Katerrrina-g/Project_SAPR/reports/bom.csv

Refs | Value | Footprint | Qty | DNP | Manufacturer_Part_Number
 | 4,7мк | SAPR:C_0201_0603Metric |  |  | GRM188Z71C475KE21D
 | 47000 | SAPR:C_0201_0603Metric |  |  | GCJ188R71E473KA01D
 | 68000 | SAPR:C_0201_0603Metric |  |  | GRM188R71H683KA93D
 | 1мк | SAPR:C_0201_0603Metric |  |  | GRM033R60J105MEA2D
 | 10мк | SAPR:C_0402_1005Metric |  |  | CC0402MRX5R6BB106
 | 22мк | SAPR:C_0402_1005Metric |  |  | GRM155R60J226ME11D
 | 1мк | SAPR:C_0201_0603Metric |  |  | GRM033R60J105MEA2D
 | 10мк | SAPR:C_0402_1005Metric |  |  | CC0402MRX5R6BB106
 | 1мк | SAPR:C_0201_0603Metric |  |  | GRM033R60J105MEA2D
 | 4,7мк | SAPR:C_0201_0603Metric |  |  | GRM188Z71C475KE21D
 | 0,01мк | SAPR:C_0201_0603Metric |  |  | GRM033R71E103KE14D
 | 10мк | SAPR:R_0402_1005Metric |  |  | CC0402MRX5R6BB106
 | 0,01мк | SAPR:C_0201_0603Metric |  |  | GRM033R71E103KE14D
 | 0,1мк | SAPR:C_0201_0603Metric |  |  | GRM033Z71C104KE14D
 | 0,1мк | SAPR:C_0201_0603Metric |  |  | GRM033Z71C104KE14D
 | 10мк | SAPR:C_1210_3225Metric |  |  | GRM32ER71H106KA12L
 | 10мк | SAPR:C_1210_3225Metric |  |  | GRM32ER71H106KA12L
 | 2,2мк | SAPR:C_0201_0603Metric |  |  | GRM188R71A225KE15D
 | 2,2мк | SAPR:C_0201_0603Metric |  |  | GRM188R71A225KE15D
 | 4,7мк | SAPR:C_0201_0603Metric |  |  | GRM188Z71C475KE21D
 | 10мк | SAPR:C_0402_1005Metric |  |  | CC0402MRX5R6BB106
 | 10мк | SAPR:C_1206_3216Metric |  |  | GRM31CR61H106KA12L
 | 10мк | SAPR:C_1206_3216Metric |  |  | GRM31CR61H106KA12L
 | 1000 | SAPR:C_0402_1005Metric |  |  | GCM155R71H102KA37J
 | 1000 | SAPR:C_0402_1005Metric |  |  | GCM155R71H102KA37J
 | 10мк | SAPR:C_0402_1005Metric |  |  | CC0402MRX5R6BB106
 | 10мк | SAPR:C_0402_1005Metric |  |  | CC0402MRX5R6BB106
 | 0,1мк | SAPR:C_0201_0603Metric |  |  | GRM033Z71C104KE14D
 | 6,8 | SAPR:C_0402_1005Metric |  |  | CC0402CRNPO9BN6R8
 | 33 | SAPR:C_0402_1005Metric |  |  | GRM1555C1H330J
 | 10мк | SAPR:C_1206_3216Metric |  |  | GRM31CR61H106KA12L
 | 10мк | SAPR:C_1206_3216Metric |  |  | GRM31CR61H106KA12L
 | 10мк | SAPR:C_0805_2012Metric |  |  | GRM21BR60J106K
 | 10мк | SAPR:C_0402_1005Metric |  |  | CC0402MRX5R6BB106
 | MDS01L-N | SAPR:MDS01L-N |  |  | MDS01L-05N
 | ISOUSB211 | SAPR:SSOP-28-ISOUSB211 |  |  | ISOUSB211DPR
 | ADP5071AREZ | SAPR:TSSOP-20_4.4x6.5mm_P0.65mm |  |  | ADP5071AREZ
 | LM3671MF-ADJ | SAPR:SOT-23-5 |  |  | LM3671MF-ADJ
 | ADP2301AUJZ-R7 | SAPR:TSOT-23-6
 | TPS7A4901DGNR | SAPR:MSOP-8-1EP_3x3mm_P0.65mm_EP1.95x2.15mm |  |  | TPS7A4901DGNR
 | TPS7A3001DGNR | SAPR:MSOP-8-1EP_3x3mm_P0.65mm_EP1.95x2.15mm |  |  | TPS7A3001DGNR
 | 47мкГн | SAPR:L_TDK_NLV32_3.2x2.5mm |  |  | NLCV32T-470K-EF
 | 6,8мк | SAPR:L_0201_0603Metric |  |  | MLF1608E6R8KTD25
 | 15мк | SAPR:L_0201_0603Metric |  |  | MLF1608C150KTA00
 | 2,2мк | SAPR:L_0201_0603Metric |  |  | ILSB0603ER2R2K
 | 6,8мк | SAPR:L_0201_0603Metric |  |  | MLF1608E6R8KTD25
 | 5,1 | SAPR:R_0402_1005Metric |  |  | RC0402FR-075R1L
 | 12к | SAPR:R_0402_1005Metric |  |  | RC0402FR-0712KL
 | 15к | SAPR:R_0402_1005Metric |  |  | RC0402FR-0715RL
 | 1Г | SAPR:R_1206_3216Metric |  |  | CRHV1206AF1G00FKET
 | 0 | SAPR:R_0201_0603Metric |  |  | RC0201FR-070RL
 | 110мк | SAPR:R_0402_1005Metric |  |  | RC0402FR-07110KL
 | 2,32М | SAPR:R_0805_2012Metric |  |  | RC0805FR-072M32L
 | 2,43М | SAPR:R_0805_2012Metric |  |  | RC0805FR-072M43L
 | 127к | SAPR:R_0402_1005Metric |  |  | RC0402FR-07127KL
 | 56к | SAPR:R_0402_1005Metric |  |  | RC0402FR-0756KL
 | 4,7к | SAPR:R_0402_1005Metric |  |  | RC0402FR-074K7L
 | 12к | SAPR:R_0402_1005Metric |  |  | RC0402FR-0712KL
 | 1к | SAPR:R_0402_1005Metric |  |  | RC0402FR-071KL
 | 12к | SAPR:R_0402_1005Metric |  |  | RC0402FR-0712KL
 | 1к | SAPR:R_0402_1005Metric |  |  | RC0402FR-071KL
 | 562к | SAPR:R_0402_1005Metric |  |  | RC0402FR-07562K
 | 100к | SAPR:R_0402_1005Metric |  |  | RC0402FR-07100KL
 | 52,3к | SAPR:R_0402_1005Metric |  |  | RC0402FR-0752K3L
 | 10к | SAPR:R_0402_1005Metric |  |  | RC0402FR-0710KL
 | SS24FL |  |  |  | SS24FL
 | DFLS240-7 | SAPR:D_PowerDI-123 |  |  | DFLS240-7
 | DFLS240-7 | SAPR:D_PowerDI-123 |  |  | DFLS240-7
 | B230A-13-F | SAPR:D_SMA |  |  | B230A-13-F
 |  | SAPR:USB_Micro-B_Molex_47346-0001
