Katerrrina-g/Project_SAPR/reports/schematic.pdf

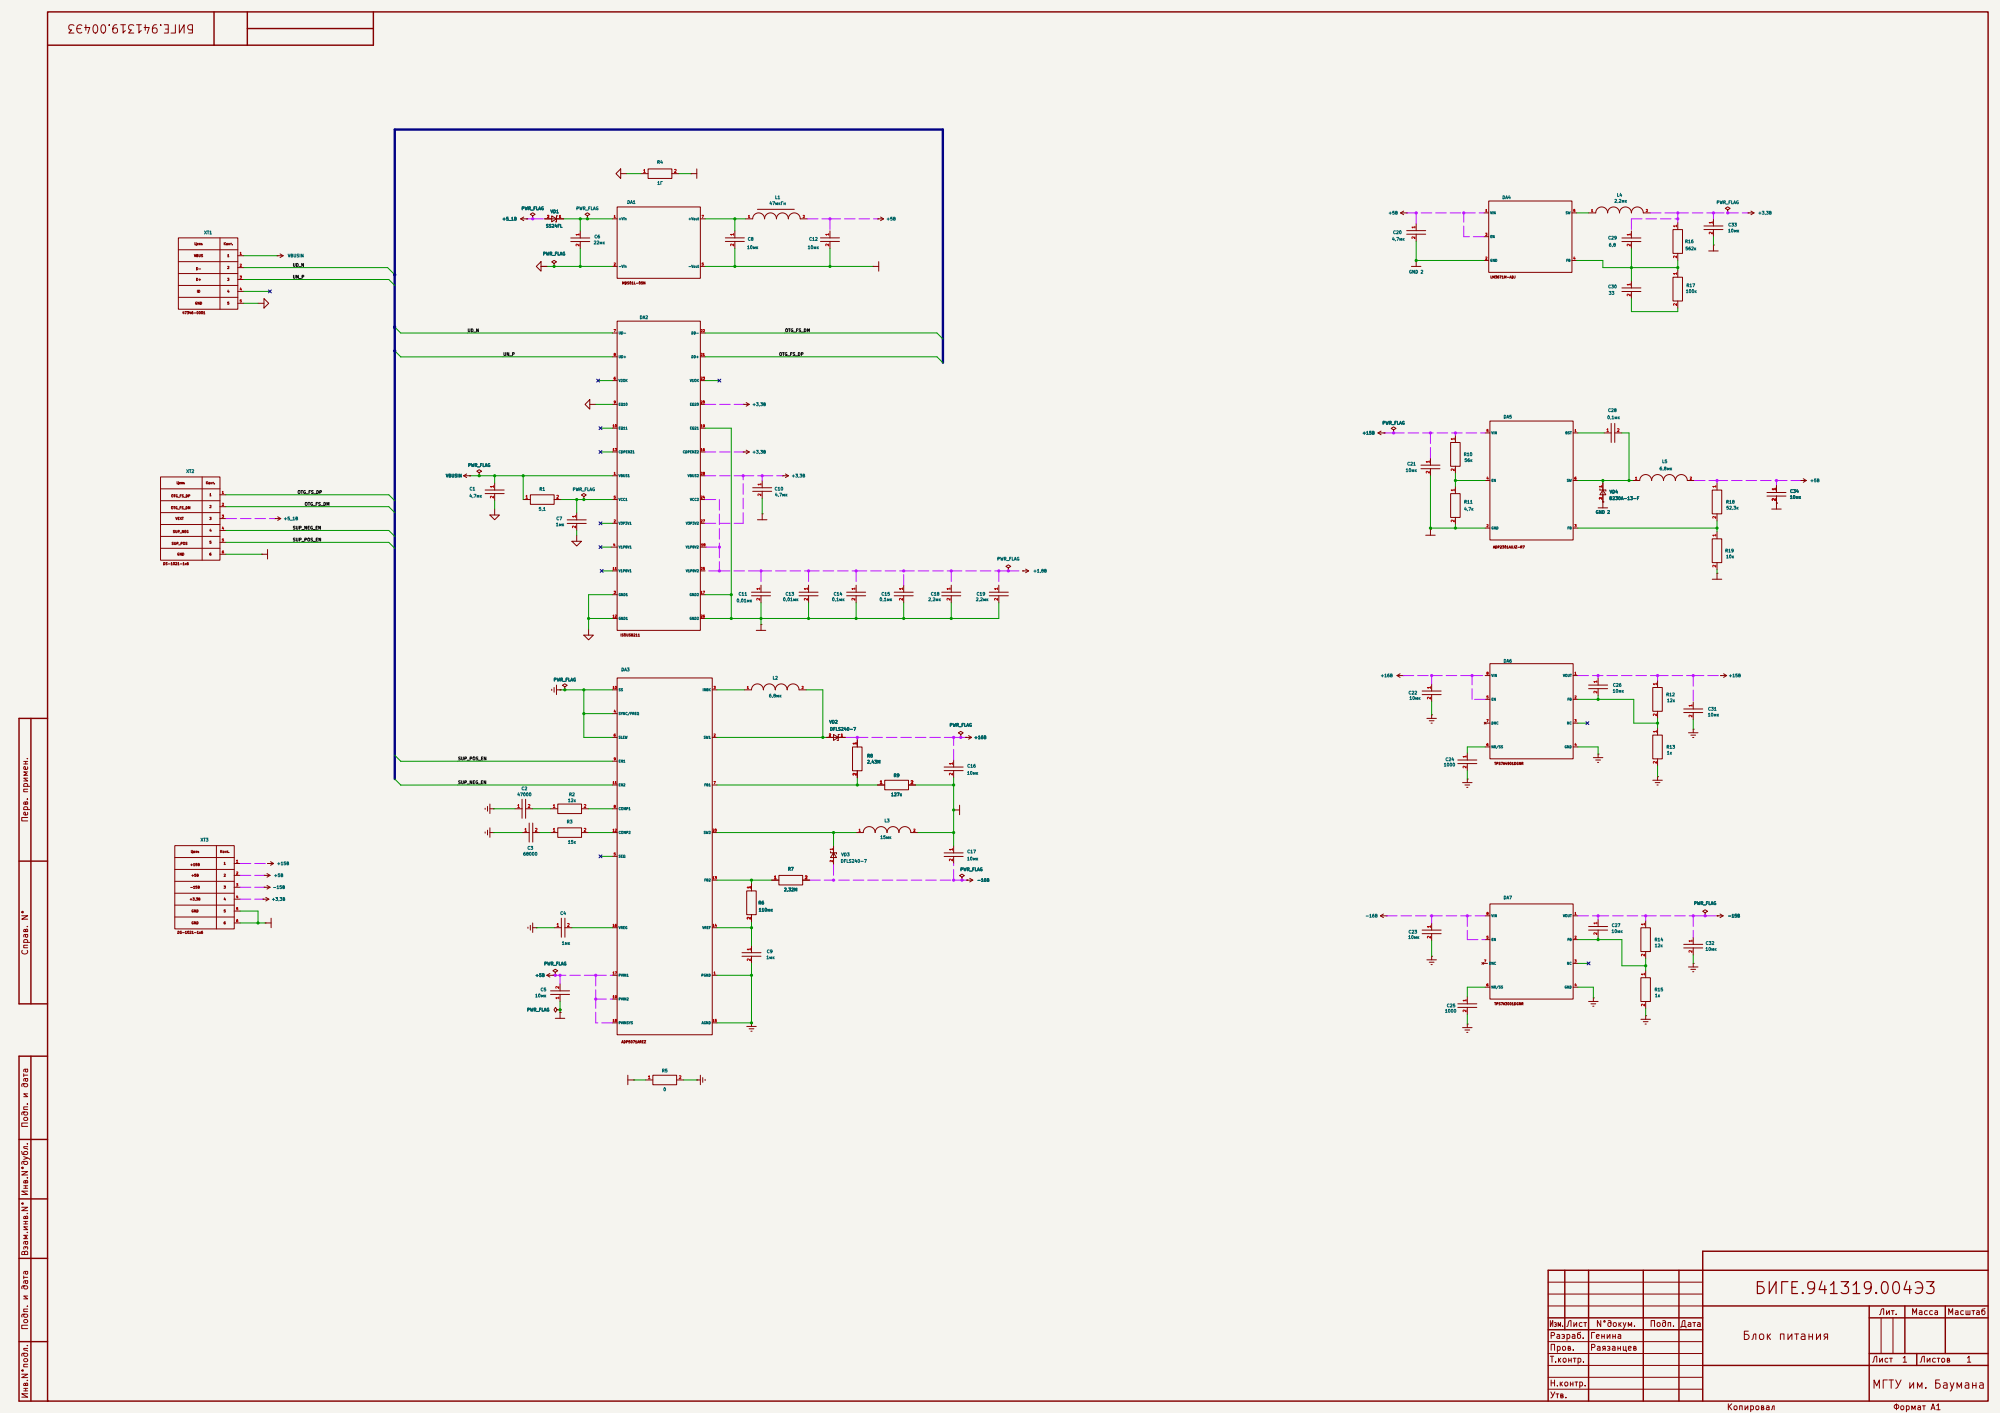
[picture p5: page 1]

47346-0001 Цепь VBUS D-

GND

Н.контр. Перв. примен. Подп. и дата Подп. и дата

DS-1021-1x6 Цепь +15В +5В -15В +3,3В

Лист | | Подп.
Генина

Пров.
Т.контр.
