Katerrrina-g/Project_SAPR/Project_sapr.kicad_pcb

## KiCad design Project_sapr.kicad_pcb (2026-10-28)

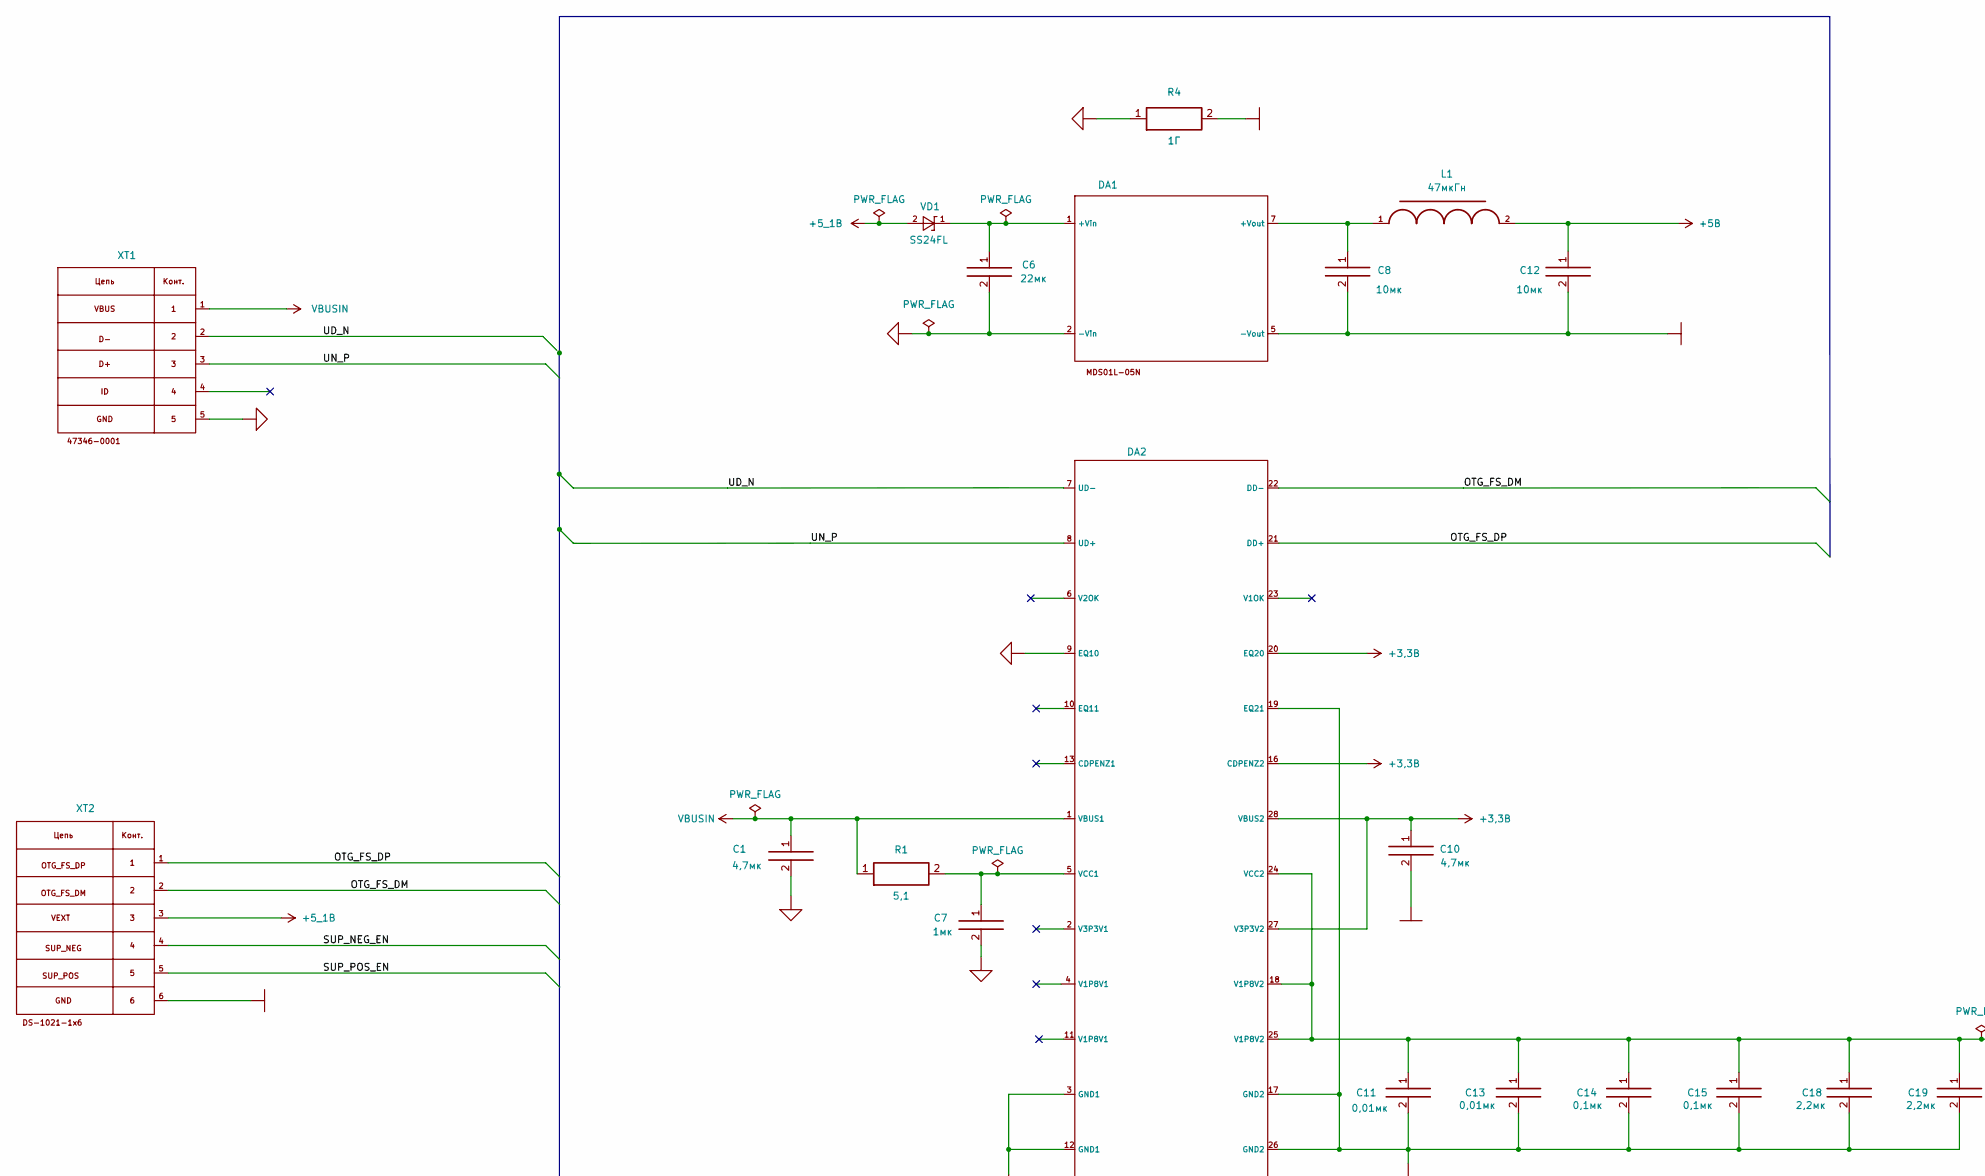
[picture p6: schematic Project_sapr.kicad_sch, Блок питания, part in row 1, column 1]

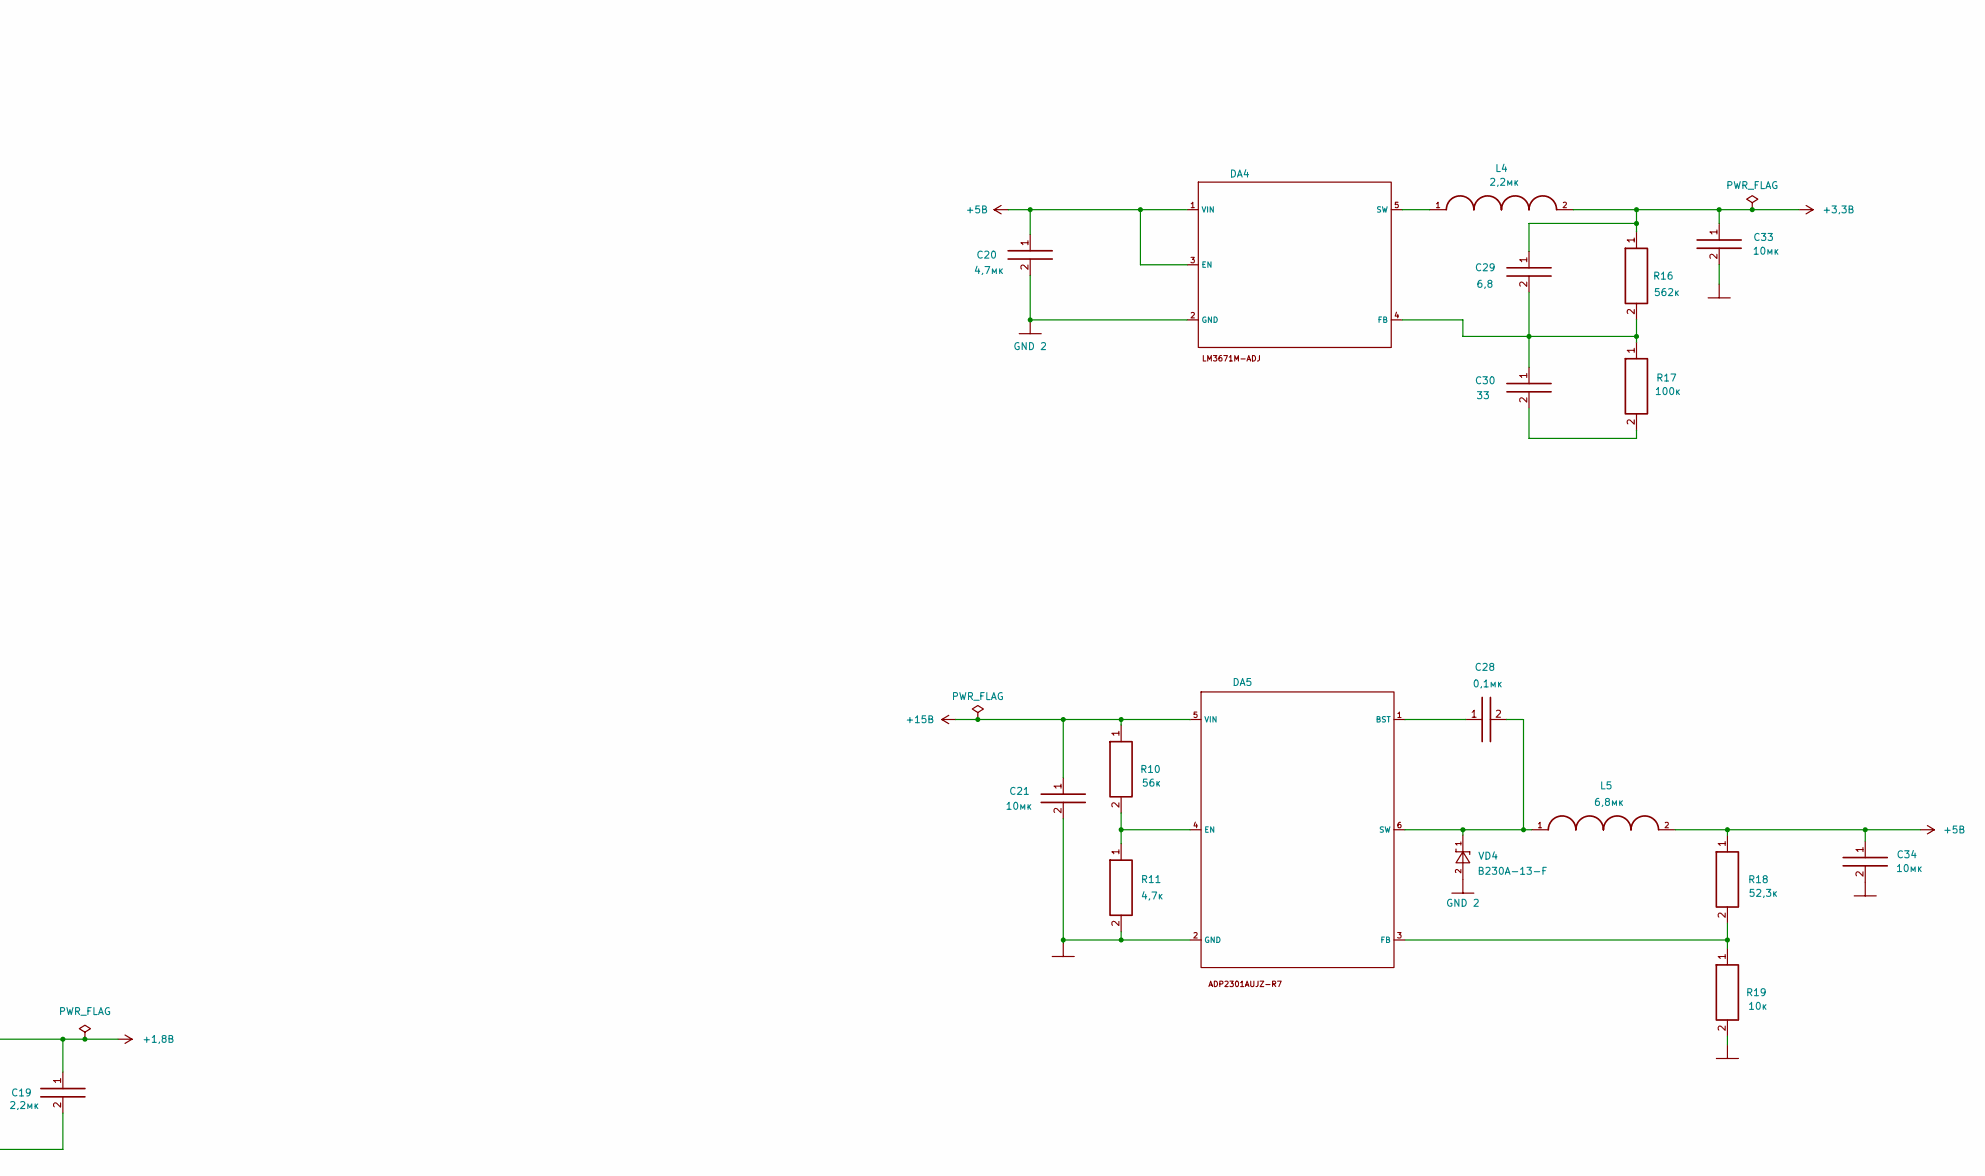
[picture p7: schematic Project_sapr.kicad_sch, Блок питания, part in row 1, column 2]

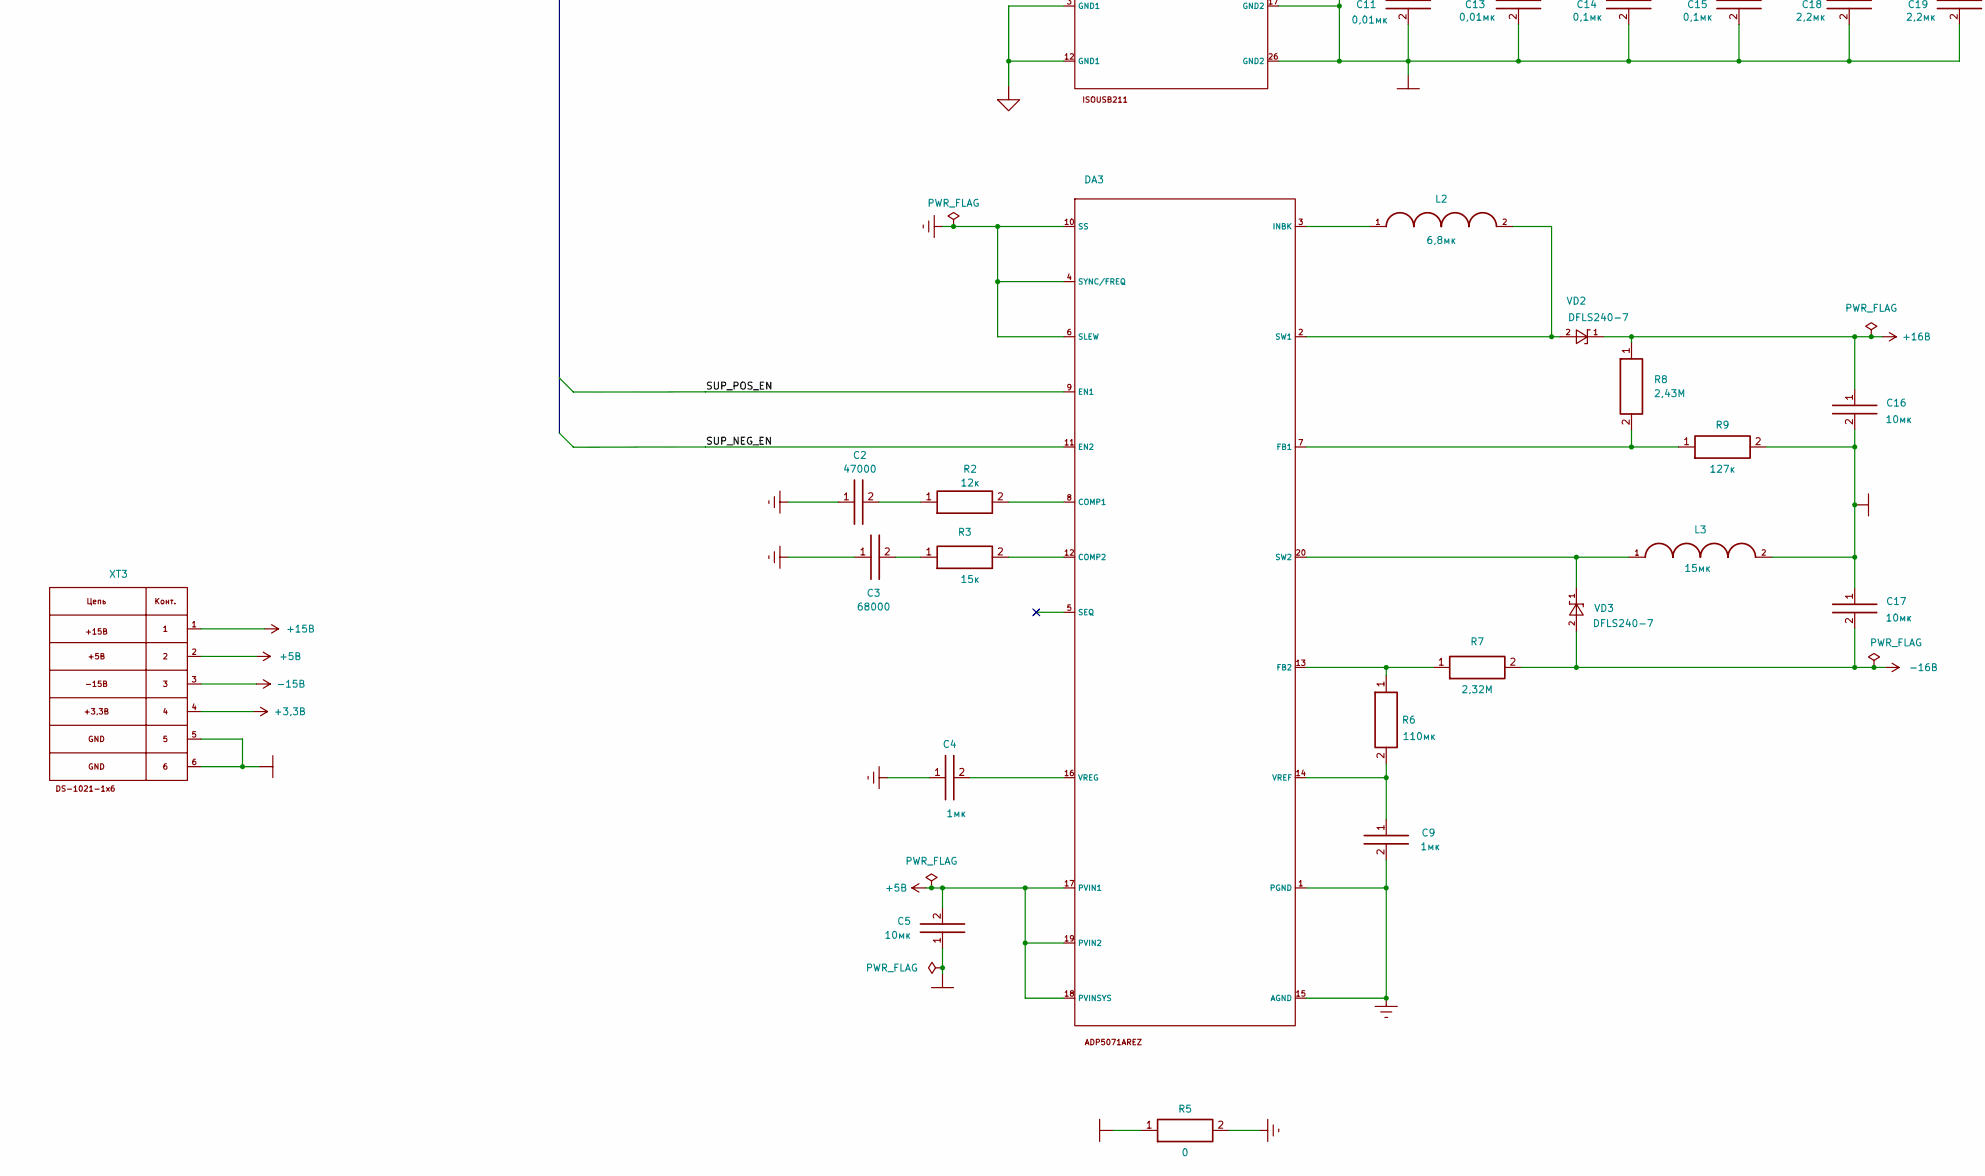
[picture p8: schematic Project_sapr.kicad_sch, Блок питания, part in row 2, column 1]

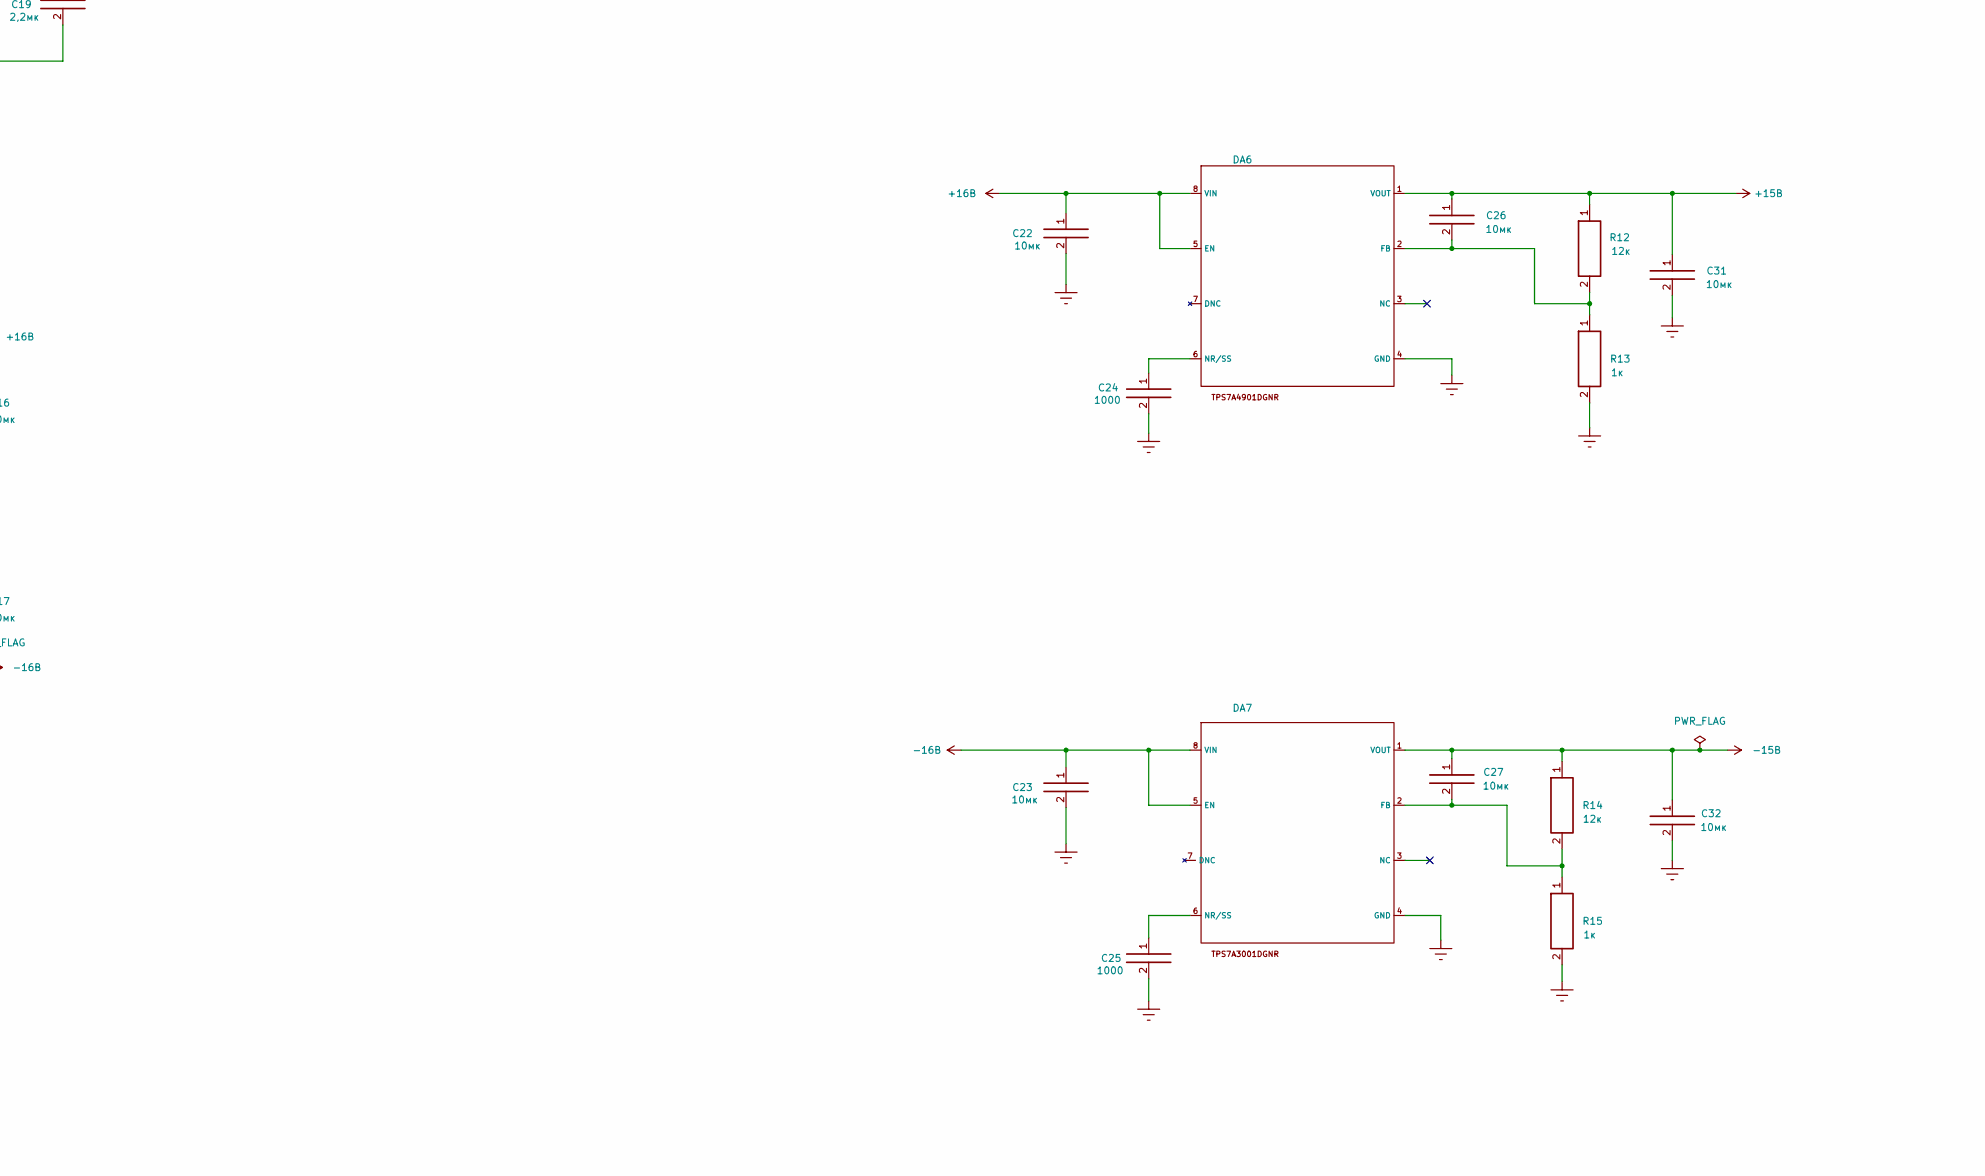
[picture p9: schematic Project_sapr.kicad_sch, Блок питания, part in row 2, column 2]

Parts:
C1, C10, C20: 4,7мк; C_0201_0603Metric; Manufacturer_Part_Number GRM188Z71C475KE21D
C2: 47000; C_0201_0603Metric; Manufacturer_Part_Number GCJ188R71E473KA01D
C3: 68000; C_0201_0603Metric; Manufacturer_Part_Number GRM188R71H683KA93D
C4, C7, C9: 1мк; C_0201_0603Metric; Manufacturer_Part_Number GRM033R60J105MEA2D
C5, C8, C21, C26, C27, C34: 10мк; C_0402_1005Metric; Manufacturer_Part_Number CC0402MRX5R6BB106
C6: 22мк; C_0402_1005Metric; Manufacturer_Part_Number GRM155R60J226ME11D
C11, C13: 0,01мк; C_0201_0603Metric; Manufacturer_Part_Number GRM033R71E103KE14D
C12: 10мк; R_0402_1005Metric; Manufacturer_Part_Number CC0402MRX5R6BB106
C14, C15, C28: 0,1мк; C_0201_0603Metric; Manufacturer_Part_Number GRM033Z71C104KE14D
C16, C17: 10мк; C_1210_3225Metric; Manufacturer_Part_Number GRM32ER71H106KA12L
C18, C19: 2,2мк; C_0201_0603Metric; Manufacturer_Part_Number GRM188R71A225KE15D
C22, C23, C31, C32: 10мк; C_1206_3216Metric; Manufacturer_Part_Number GRM31CR61H106KA12L
C24, C25: 1000; C_0402_1005Metric; Manufacturer_Part_Number GCM155R71H102KA37J
C29: 6,8; C_0402_1005Metric; Manufacturer_Part_Number CC0402CRNPO9BN6R8
C30: 33; C_0402_1005Metric; Manufacturer_Part_Number GRM1555C1H330J
C33: 10мк; C_0805_2012Metric; Manufacturer_Part_Number GRM21BR60J106K
DA1: MDS01L-N; Manufacturer_Part_Number MDS01L-05N
DA2: ISOUSB211; SSOP-28-ISOUSB211; Manufacturer_Part_Number ISOUSB211DPR
DA3: ADP5071AREZ; TSSOP-20_4.4x6.5mm_P0.65mm; Manufacturer_Part_Number ADP5071AREZ
DA4: LM3671MF-ADJ; SOT-23-5; Manufacturer_Part_Number LM3671MF-ADJ
DA5: ADP2301AUJZ-R7; TSOT-23-6
DA6: TPS7A4901DGNR; MSOP-8-1EP_3x3mm_P0.65mm_EP1.95x2.15mm; Manufacturer_Part_Number TPS7A4901DGNR
DA7: TPS7A3001DGNR; MSOP-8-1EP_3x3mm_P0.65mm_EP1.95x2.15mm; Manufacturer_Part_Number TPS7A3001DGNR
L1: 47мкГн; L_TDK_NLV32_3.2x2.5mm; Manufacturer_Part_Number NLCV32T-470K-EF
L2, L5: 6,8мк; L_0201_0603Metric; Manufacturer_Part_Number MLF1608E6R8KTD25
L3: 15мк; L_0201_0603Metric; Manufacturer_Part_Number MLF1608C150KTA00
L4: 2,2мк; L_0201_0603Metric; Manufacturer_Part_Number ILSB0603ER2R2K
R1: 5,1; R_0402_1005Metric; Manufacturer_Part_Number RC0402FR-075R1L
R2, R12, R14: 12к; R_0402_1005Metric; Manufacturer_Part_Number RC0402FR-0712KL
R3: 15к; R_0402_1005Metric; Manufacturer_Part_Number RC0402FR-0715RL
R4: 1Г; R_1206_3216Metric; Manufacturer_Part_Number CRHV1206AF1G00FKET
R5: 0; R_0201_0603Metric; Manufacturer_Part_Number RC0201FR-070RL
R6: 110мк; R_0402_1005Metric; Manufacturer_Part_Number RC0402FR-07110KL
R7: 2,32М; R_0805_2012Metric; Manufacturer_Part_Number RC0805FR-072M32L
R8: 2,43М; R_0805_2012Metric; Manufacturer_Part_Number RC0805FR-072M43L
R9: 127к; R_0402_1005Metric; Manufacturer_Part_Number RC0402FR-07127KL
R10: 56к; R_0402_1005Metric; Manufacturer_Part_Number RC0402FR-0756KL
R11: 4,7к; R_0402_1005Metric; Manufacturer_Part_Number RC0402FR-074K7L
R13, R15: 1к; R_0402_1005Metric; Manufacturer_Part_Number RC0402FR-071KL
R16: 562к; R_0402_1005Metric; Manufacturer_Part_Number RC0402FR-07562K
R17: 100к; R_0402_1005Metric; Manufacturer_Part_Number RC0402FR-07100KL
R18: 52,3к; R_0402_1005Metric; Manufacturer_Part_Number RC0402FR-0752K3L
R19: 10к; R_0402_1005Metric; Manufacturer_Part_Number RC0402FR-0710KL
VD1: SS24FL; Manufacturer_Part_Number SS24FL
VD2, VD3: DFLS240-7; D_PowerDI-123; Manufacturer_Part_Number DFLS240-7
VD4: B230A-13-F; D_SMA; Manufacturer_Part_Number B230A-13-F
XT1: USB_Micro-B_Molex_47346-0001
XT2, XT3: (no value)

Connections:
+1,8B: C11.1, C13.1, C14.1, C15.1, C18.1, C19.1, DA2.18 (V1P8V2), DA2.24 (VCC2), DA2.25 (V1P8V2)
+3,3B: C10.1, C29.1, C33.1, DA2.16 (CDPENZ2), DA2.20 (EQ20), DA2.27 (V3P3V2), DA2.28 (VBUS2), L4.2, R16.1, XT3.4
+5B: C5.2, C12.1, C20.1, C34.1, DA3.17 (PVIN1), DA3.18 (PVINSYS), DA3.19 (PVIN2), DA4.1 (VIN), DA4.3 (EN), L1.2, L5.2, R18.1, XT3.2
+5_1B: VD1.2, XT2.3
+15B: C21.1, C26.1, C31.1, DA5.5 (VIN), DA6.1 (VOUT), R10.1, R12.1, XT3.1
+16B: C16.1, C22.1, DA6.5 (EN), DA6.8 (VIN), R8.1, VD2.1
-15B: C27.1, C32.1, DA7.1 (VOUT), R14.1, XT3.3
-16B: C17.2, C23.1, DA7.5 (EN), DA7.8 (VIN), R7.2, VD3.2
/OTG_FS_DM: DA2.22 (DD-), XT2.2
/OTG_FS_DP: DA2.21 (DD+), XT2.1
/SUP_NEG_EN: DA3.11 (EN2), XT2.4
/SUP_POS_EN: DA3.9 (EN1), XT2.5
/UD_N: DA2.7 (UD-), XT1.2
/UN_P: DA2.8 (UD+), XT1.3
GND 1: C1.2, C6.2, C7.2, DA1.2 (-Vin), DA2.3 (GND1), DA2.9 (EQ10), DA2.12 (GND1), R4.1, XT1.5
GND 2: C5.1, C8.2, C10.2, C11.2, C12.2, C13.2, C14.2, C15.2, C16.2, C17.1, C18.2, C19.2, C20.2, C21.2, C33.2, C34.2, DA1.5 (-Vout), DA2.17 (GND2), DA2.19 (EQ21), DA2.26 (GND2), DA4.2 (GND), DA5.2 (GND), L3.2, R4.2, R5.1, R9.2, R11.2, R19.2, VD4.2, XT2.6, XT3.5, XT3.6
GND 3: C2.1, C3.1, C4.1, C9.2, C22.2, C23.2, C24.2, C25.2, C31.2, C32.2, DA3.1 (PGND), DA3.4 (SYNC/FREQ), DA3.6 (SLEW), DA3.10 (SS), DA3.15 (AGND), DA6.4 (GND), DA7.4 (GND), R5.2, R13.2, R15.2
unnamed: C2.2, R2.1
unnamed: C3.2, R3.1
unnamed: C30.2, R17.2
unnamed: C6.1, DA1.1 (+Vin), VD1.1
unnamed: C8.1, DA1.7 (+Vout), L1.1
unnamed: C7.1, DA2.5 (VCC1), R1.2
unnamed: DA3.8 (COMP1), R2.2
unnamed: DA3.12 (COMP2), R3.2
unnamed: DA3.7 (FB1), R8.2, R9.1
unnamed: DA3.13 (FB2), R6.1, R7.1
unnamed: DA3.3 (INBK), L2.1
unnamed: DA3.2 (SW1), L2.2, VD2.2
unnamed: DA3.20 (SW2), L3.1, VD3.1
unnamed: C9.1, DA3.14 (VREF), R6.2
unnamed: C4.2, DA3.16 (VREG)
unnamed: C29.2, C30.1, DA4.4 (FB), R16.2, R17.1
unnamed: DA4.5 (SW), L4.1
unnamed: C28.1, DA5.1 (BST)
unnamed: DA5.4 (EN), R10.2, R11.1
unnamed: DA5.3 (FB), R18.2, R19.1
unnamed: C28.2, DA5.6 (SW), L5.1, VD4.1
unnamed: C26.2, DA6.2 (FB), R12.2, R13.1
unnamed: C24.1, DA6.6 (NR/SS)
unnamed: C27.2, DA7.2 (FB), R14.2, R15.1
unnamed: C25.1, DA7.6 (NR/SS)
VBUSIN: C1.1, DA2.1 (VBUS1), R1.1, XT1.1

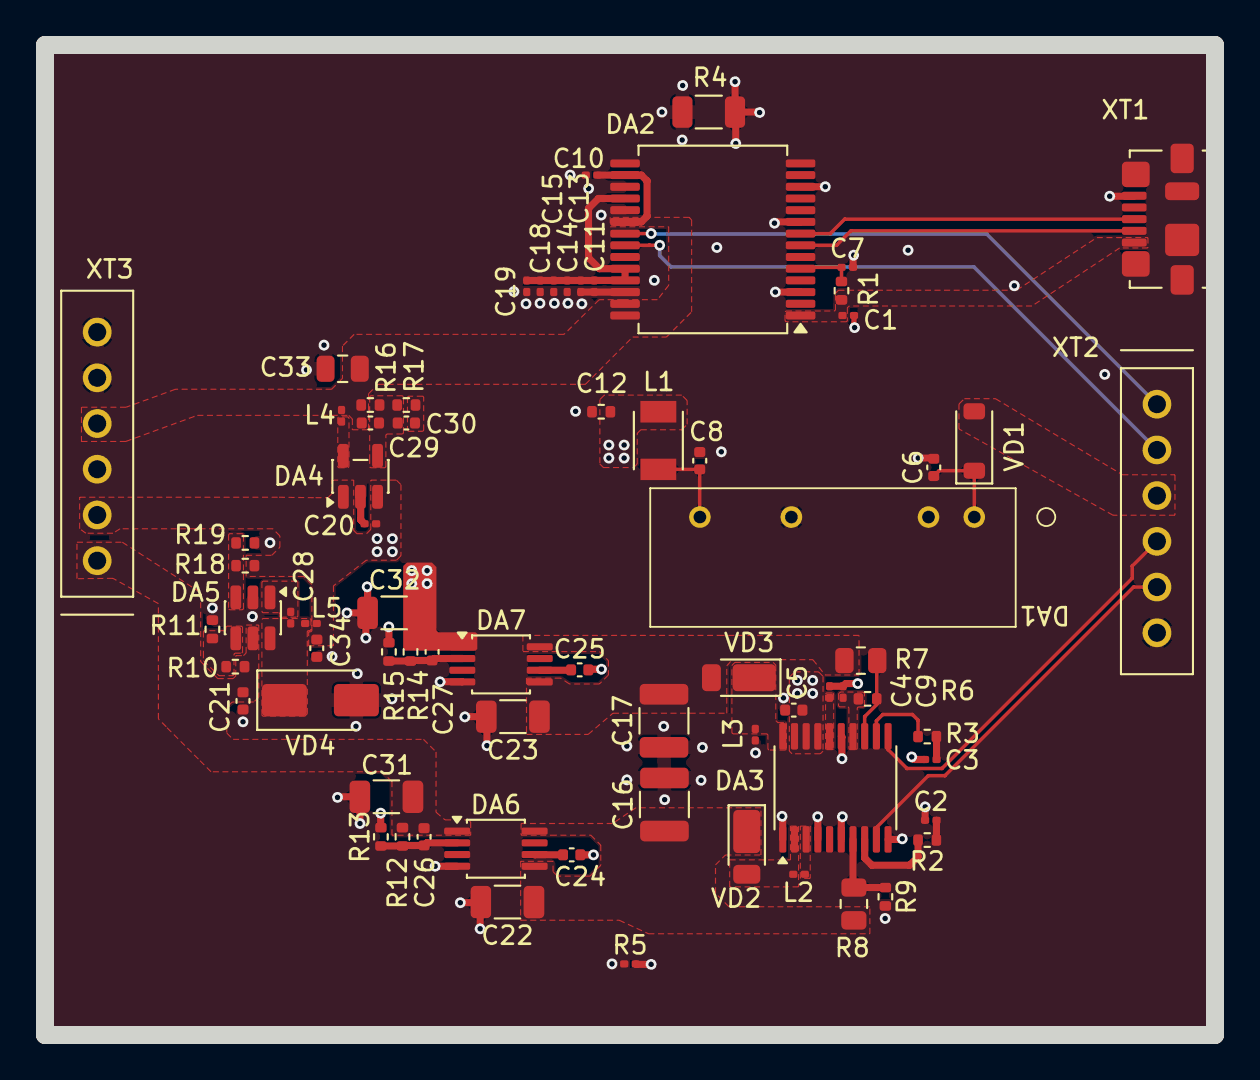
[picture p10: board Project_sapr.kicad_pcb from above]

Board: 4 copper layers, 65.0 x 55.0 mm, 72 parts (0 on the bottom side), 43 nets.
