Katerrrina-g/Project_SAPR/(commit log)

2026-10-01 добавлена библиотека как сабмодуль
    [Project_sapr.kicad_pcb, Project_sapr.kicad_sch]
2026-10-05 Новая версия библиотеки
    [Project_sapr.kicad_sch]
2026-10-05 Обновлена версия библиотеки в проекте
2026-10-06 Обновлена версия библиотеки с УГО по ГОСТ
2026-10-28 Финальная сборка
    [Project_sapr-B_Courtyard.gbr, Project_sapr-B_Cu.gbl, Project_sapr-B_Fab.gbr, Project_sapr-B_Mask.gbs, Project_sapr-B_Paste.gbp, Project_sapr-B_Silkscreen.gbo, Project_sapr-Edge_Cuts.gm1, Project_sapr-F_Courtyard.gbr]
2026-10-28 Финальная сборка: настроен BOM, добавлен README и скрипты
